rosmo/qmk_firmware/keyboards/rosmo/kicad/Trackpoint2040.step

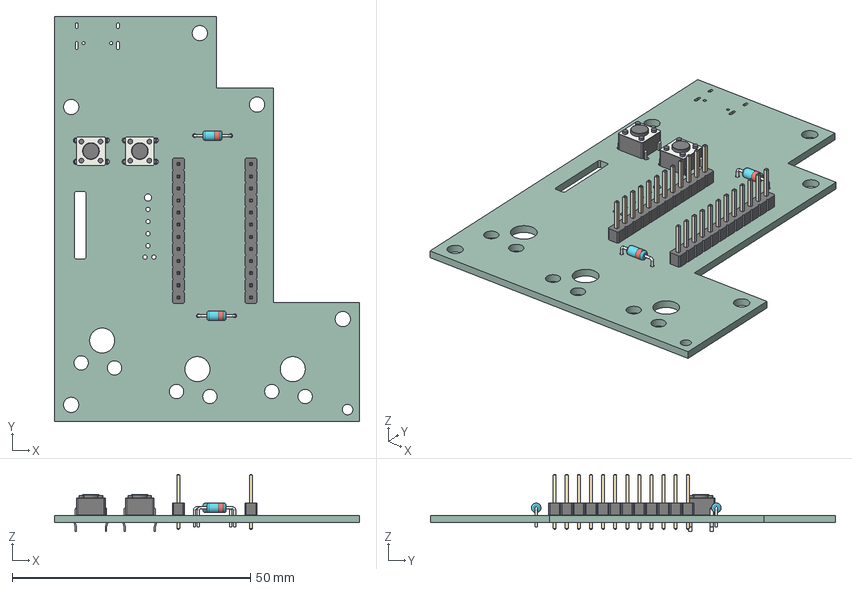
[picture p2: CAD file, 2026-04-05]
keyboards/rosmo/kicad/Trackpoint2040.step
64.0 x 85.0 x 12.0 mm
D_DO-35_SOD27_P7.62mm_Horizontal x 2
PinHeader_1x12_P2.54mm_Vertical x 2
SW_PUSH_6mm x 2
Trackpoint2040_PCB
