rosmo/qmk_firmware/(list of files, cad)

Other CAD files:
keyboards/rosmo/case/Trackpoint 2040.f3d
