rosmo/qmk_firmware/keyboards/rosmo/kicad/Trackpoint2040.kicad_pcb

## KiCad design keyboards/rosmo/kicad/Trackpoint2040.kicad_pcb (2026-04-05)

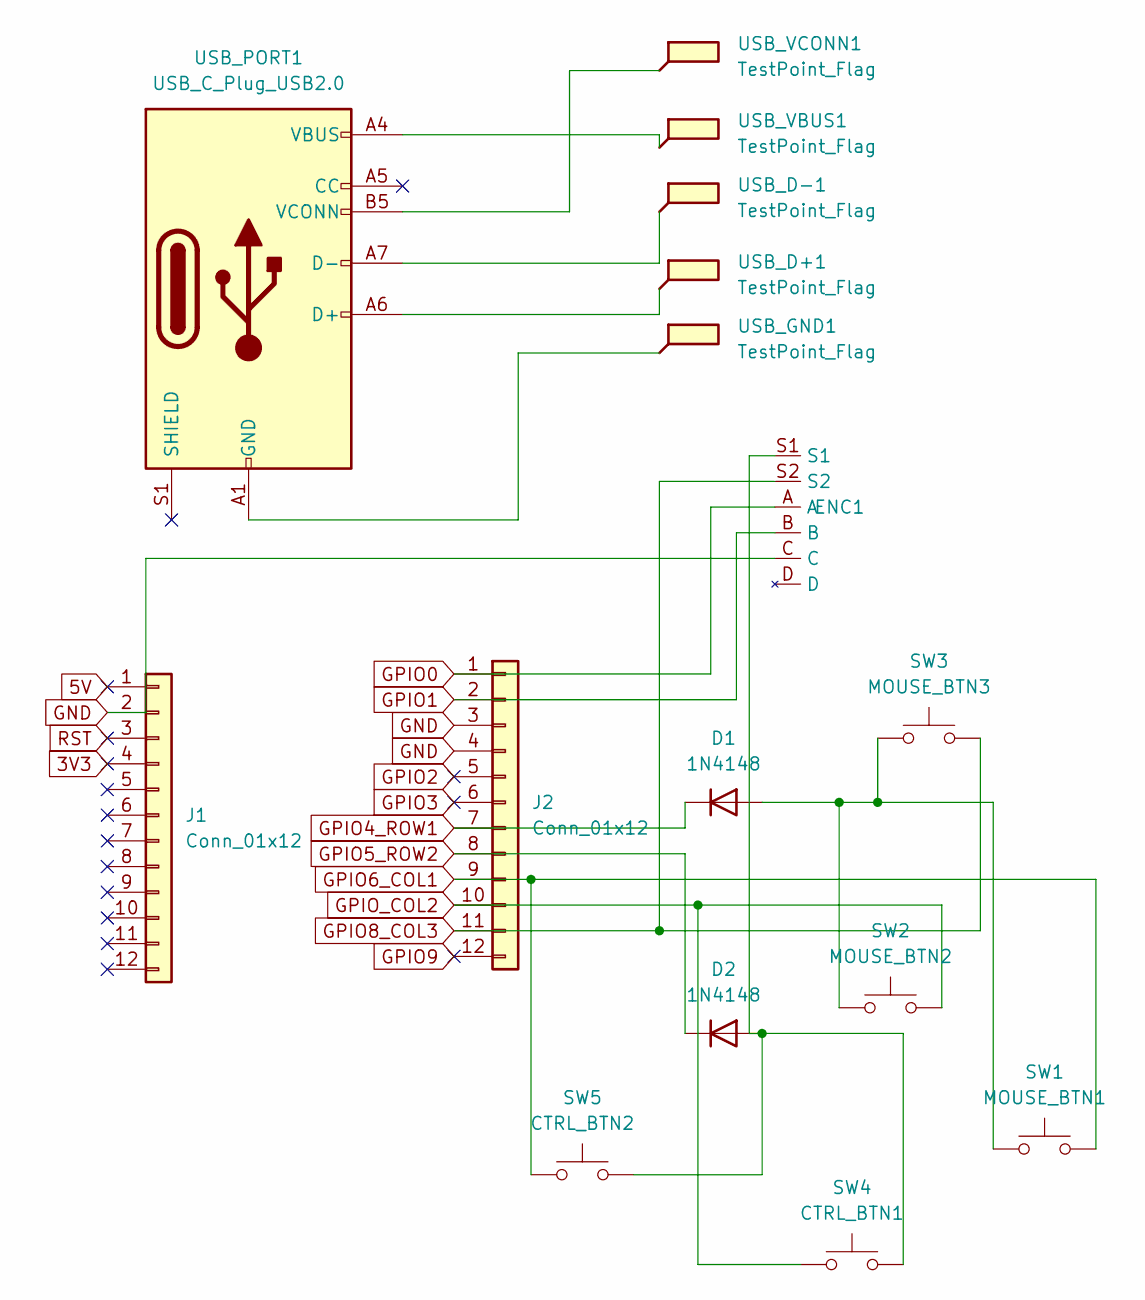
[picture p3: schematic Trackpoint2040.kicad_sch, Trackpoint module for Keychron Q11]

Parts:
D1, D2: 1N4148; D_DO-35_SOD27_P7.62mm_Horizontal
ENC1: RollerEncoder_Panasonic_EVQWGD001
J1, J2: Conn_01x12; PinHeader_1x12_P2.54mm_Vertical
SW1: MOUSE_BTN1; SW_Gateron_LowProfile_HotSwap_PTH
SW2: MOUSE_BTN2; SW_Gateron_LowProfile_HotSwap_PTH
SW3: MOUSE_BTN3; SW_Gateron_LowProfile_HotSwap_PTH
SW4: CTRL_BTN1; SW_PUSH_6mm
SW5: CTRL_BTN2; SW_PUSH_6mm
USB_D+1: TestPoint_Flag; TestPoint_Pad_2.0x2.0mm
USB_D-1: TestPoint_Flag; TestPoint_Pad_2.0x2.0mm
USB_GND1: TestPoint_Flag; TestPoint_Pad_2.0x2.0mm
USB_PORT1: USB_C_Plug_USB2.0; USB_C_Receptacle_XKB_U262-16XN-4BVC11
USB_VBUS1: TestPoint_Flag; TestPoint_Pad_2.0x2.0mm
USB_VCONN1: TestPoint_Flag; TestPoint_Pad_2.0x2.0mm

Connections:
3V3: J1.4
5V: J1.1
GND: ENC1.C, J1.2, J2.3, J2.4
GPIO0: ENC1.A, J2.1
GPIO1: ENC1.B, J2.2
GPIO2: J2.5
GPIO3: J2.6
GPIO4_ROW1: D1.1 (K), J2.7
GPIO5_ROW2: D2.1 (K), J2.8
GPIO6_COL1: J2.9, SW1.2, SW5.1
GPIO8_COL3: ENC1.S2, J2.11, SW3.2
GPIO9: J2.12
GPIO_COL2: J2.10, SW2.2, SW4.1
unnamed: D1.2 (A), SW1.1, SW2.1, SW3.1
unnamed: D2.2 (A), ENC1.S1, SW4.2, SW5.2
unnamed: USB_GND1.1, USB_PORT1.A1 (GND), USB_PORT1.A12 (GND), USB_PORT1.B1 (GND), USB_PORT1.B12 (GND)
unnamed: USB_D+1.1, USB_PORT1.A6 (D+)
unnamed: USB_D-1.1, USB_PORT1.A7 (D-)
unnamed: USB_PORT1.A4 (VBUS), USB_PORT1.A9 (VBUS), USB_PORT1.B4 (VBUS), USB_PORT1.B9 (VBUS), USB_VBUS1.1
unnamed: USB_PORT1.B5 (VCONN), USB_VCONN1.1
RST: J1.3

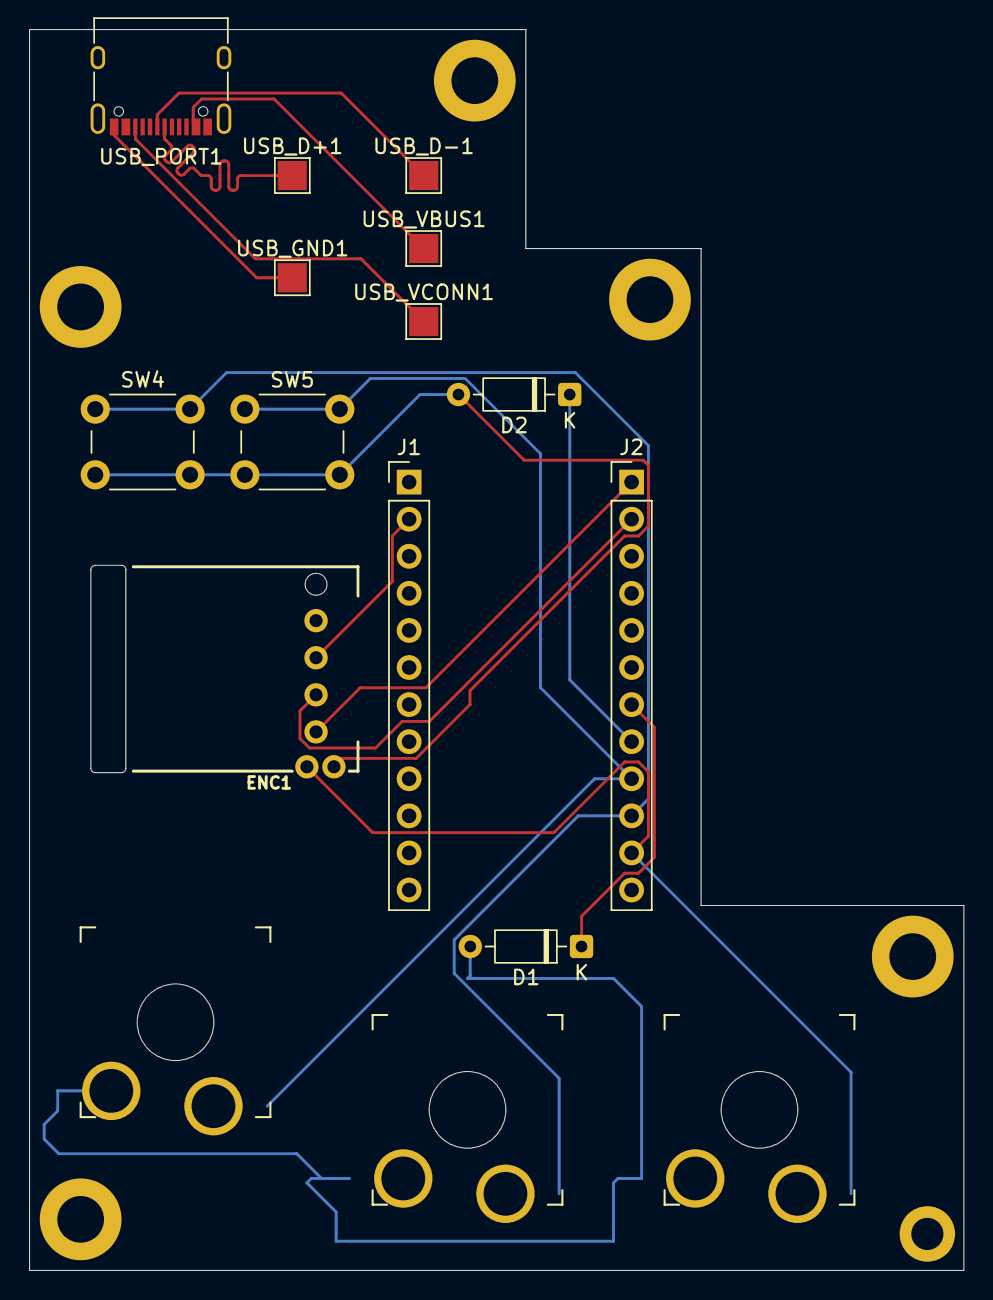
[picture p4: board Trackpoint2040.kicad_pcb from above]

Board: 2 copper layers, 64.0 x 85.0 mm, 16 parts (0 on the bottom side), 15 nets.
