rosmo/qmk_firmware/(commit log)

2026-04-05 Keymap changes, add docs, add KiCad files
    [Trackpoint2040.kicad_pcb, Trackpoint2040.kicad_sch, Trackpoint2040.step]
2026-04-05 Add Fusion files for case
    [Trackpoint 2040.f3d]
